Muhammad-Zaidan/monitoring-kontrol-ac/skematik & diagram blok/master_bb.png

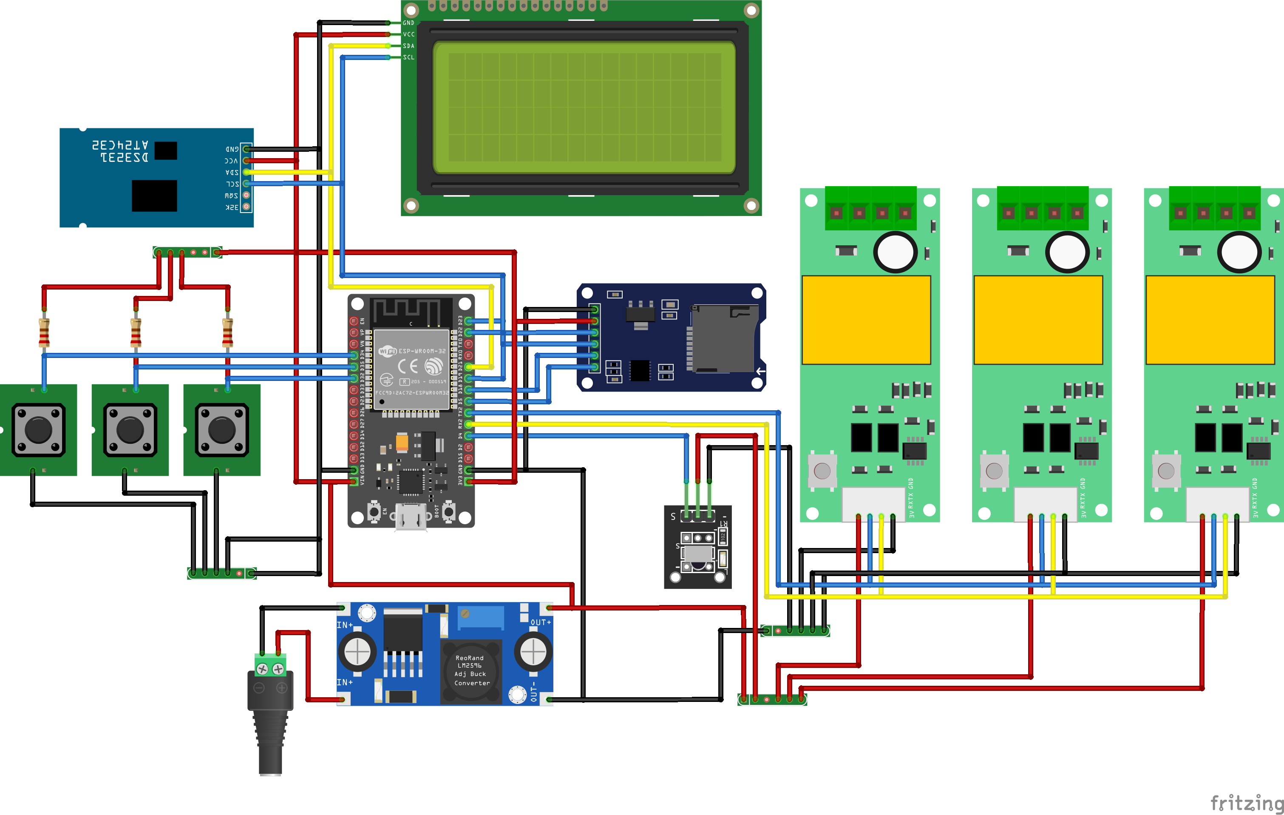
skematik & diagram blok/master_bb.png
