Muhammad-Zaidan/monitoring-kontrol-ac/skematik & diagram blok/master_schem.png

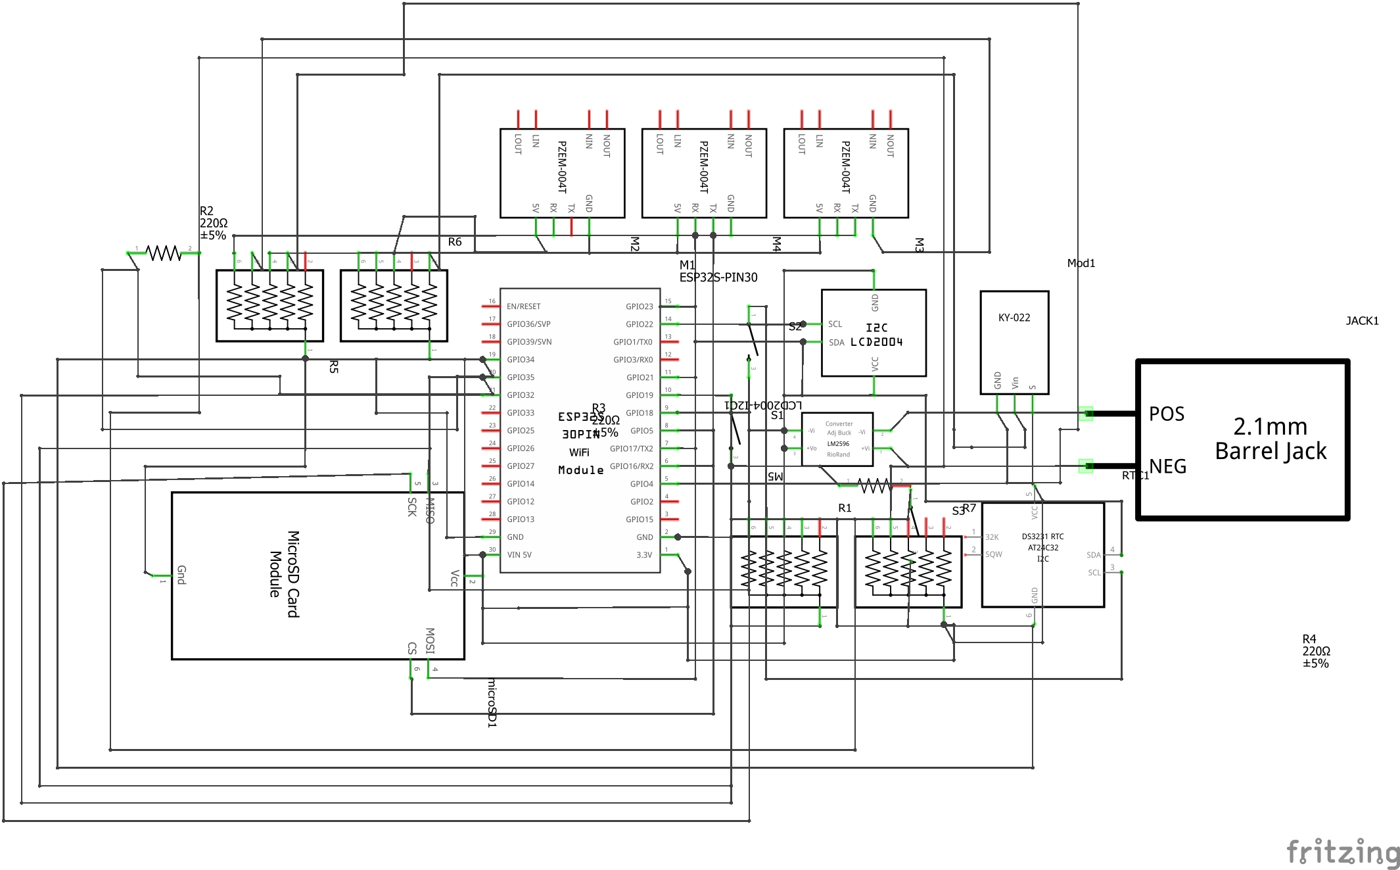
skematik & diagram blok/master_schem.png
