Muhammad-Zaidan/monitoring-kontrol-ac/skematik & diagram blok/slave_bb.png

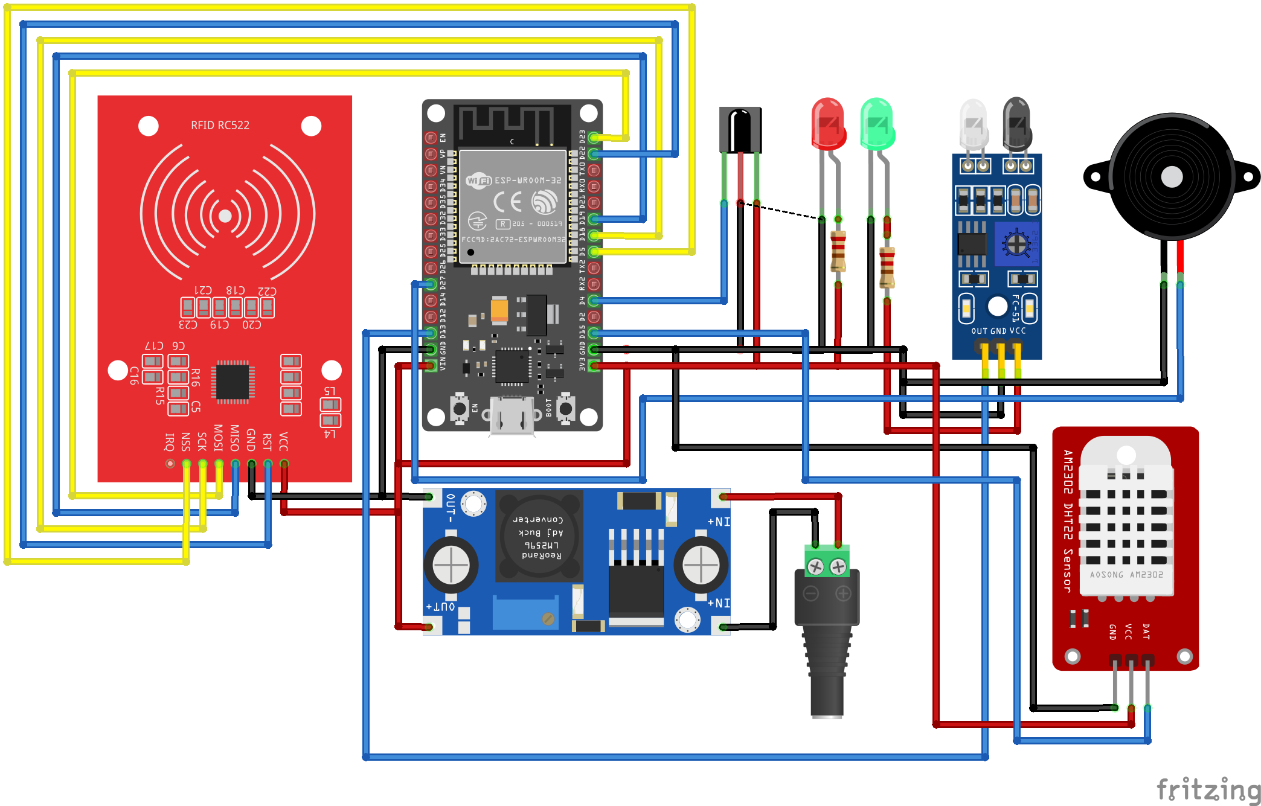
skematik & diagram blok/slave_bb.png
