Muhammad-Zaidan/monitoring-kontrol-ac/skematik & diagram blok/slave_schem.png

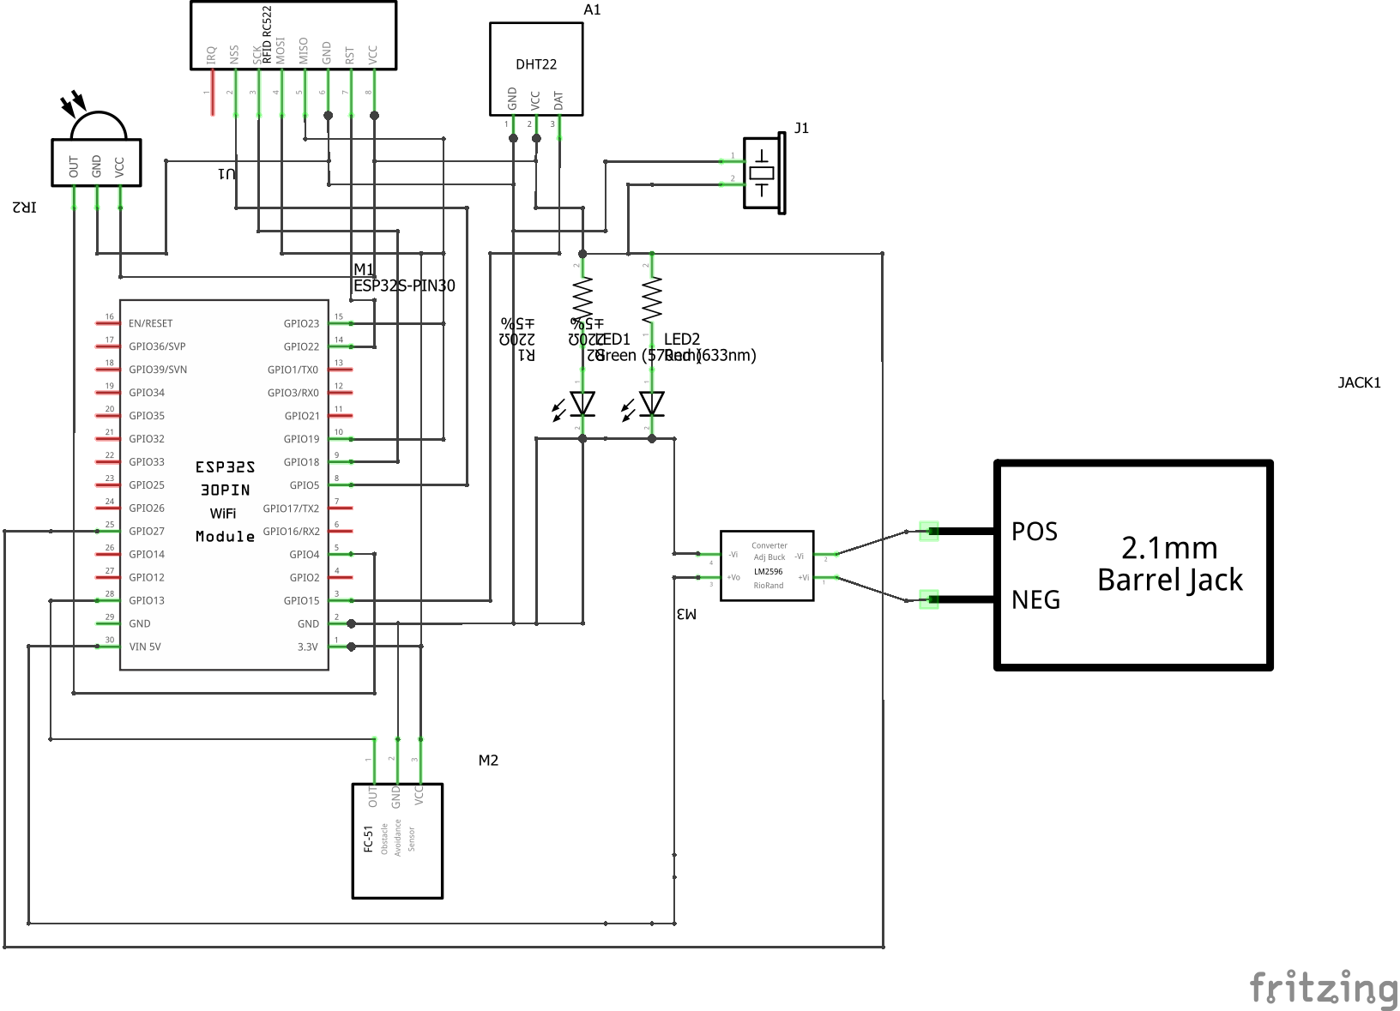
skematik & diagram blok/slave_schem.png
