Muhammad-Zaidan/monitoring-kontrol-ac/skematik & diagram blok/Untitled Diagram.drawio.png

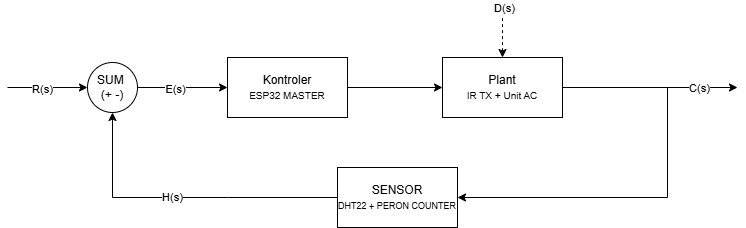
skematik & diagram blok/Untitled Diagram.drawio.png
