Muhammad-Zaidan/monitoring-kontrol-ac/(list of files, drawings)

Other design files:
skematik & diagram blok/master.fzz
skematik & diagram blok/slave.fzz
